yaqwsx/LaserProjector/README.md

# LaserProjector
Fancy driver for cheap Chinese laser galvos based on ESP32
