yaqwsx/LaserProjector/hw/mainBoard.kicad_pcb

## KiCad design hw/mainBoard.kicad_pcb (2017-08-06)

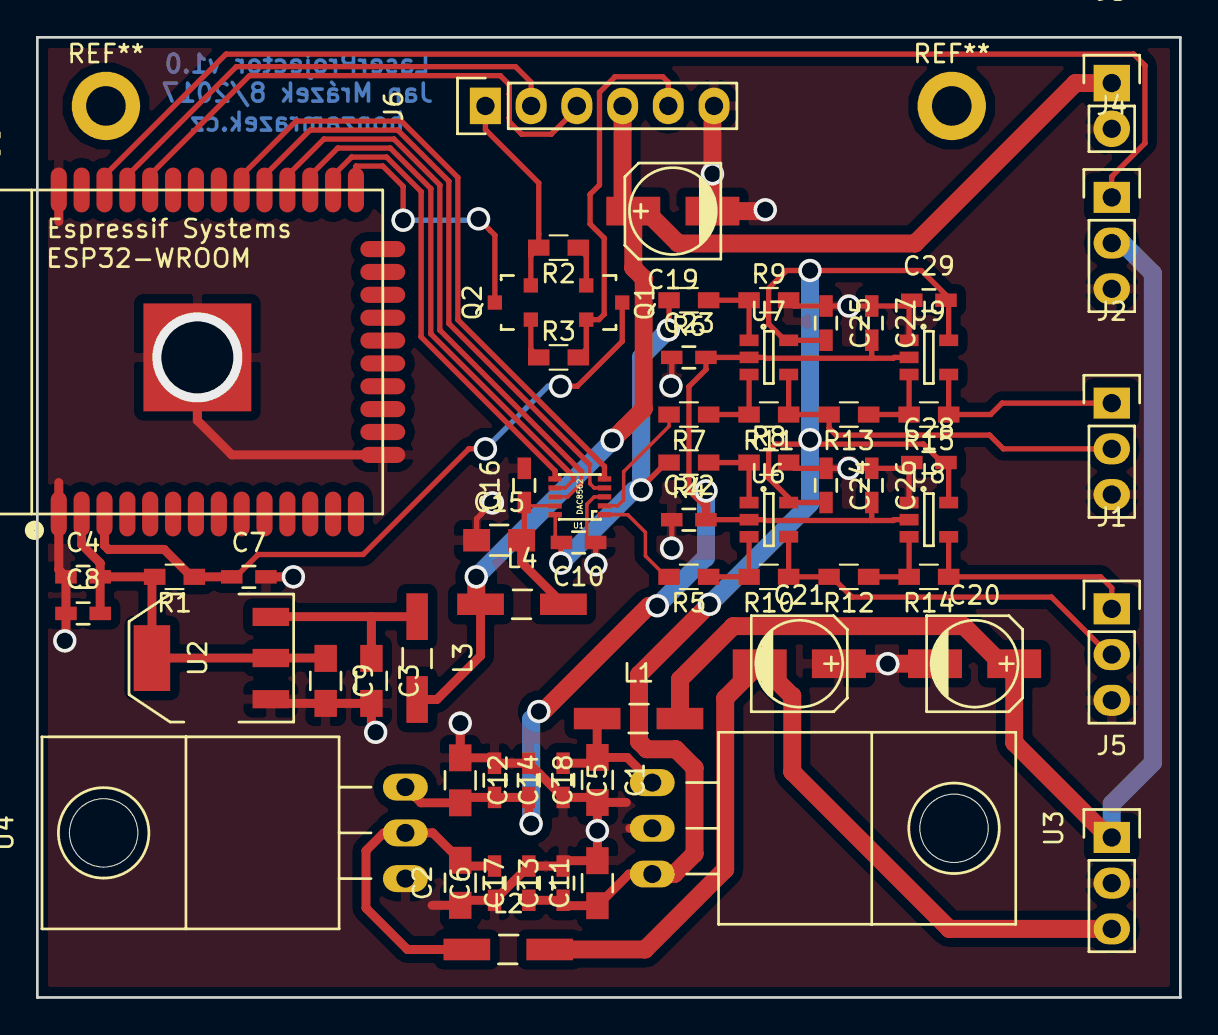
[picture p1: board mainBoard.kicad_pcb from above]

Board: 2 copper layers, 63.5 x 53.3 mm, 65 parts (0 on the bottom side), 38 nets.

Parts:
C1, C2, C3, C9, C11, C12, C15: 10u; C_0805_HandSoldering
C4: 470n; C_0603_HandSoldering
C5, C6, C8, C13, C14, C16, C22, C23, C24, C25, C26, C27, C28, C29: 100n; C_0603_HandSoldering
C7, C17, C18: 1n; C_0603_HandSoldering
C10: 150nF; C_0603_HandSoldering
C19, C20, C21: 120u; c_elec_5x5.7
J1: Y; Pin_Header_Straight_1x03
J2: X; Pin_Header_Straight_1x03
J3: PWR_5; Pin_Header_Straight_1x02
J4: LASER; Pin_Header_Straight_1x03
J5: PWR_15; Pin_Header_Straight_1x03
J6: FTDI; Pin_Header_Straight_1x06
L1, L2, L3, L4: 33uH; Choke_SMD_1206_Handsoldering
Q1, Q2: BC817; SOT-23
R1, R2, R3, R4, R5, R6, R7: 10k; R_0603_HandSoldering
R8, R9, R10, R11, R12, R13, R14, R15: 20k; R_0603_HandSoldering
U1: DAC8562; VSSOP10
U2: AP1117; SOT-223
U3: LM7809CT; TO-220_Neutral123_Horizontal
U4: LM7909CT; TO-220_Neutral123_Horizontal
U5: ESP32-WROOM
U6, U7, U8, U9: MIC920; SOT-23-5

Connections:
+3V3: C4.2, C8.2, C9.1, R1.2, U2.2, U2.4, U5.2
+5V: C19.1, J3.1, J6.4, L3.2, L4.1
+9VA: C11.1, C13.1, C17.1, C24.2, C25.2, C28.2, C29.2, U3.3, U6.5, U7.5, U8.5, U9.5
+15V: C20.1, J4.2, J5.1, L1.2
-9VA: C12.2, C14.2, C18.2, C22.2, C23.2, C26.2, C27.2, U4.3, U6.2, U7.2, U8.2, U9.2
-15V: C21.2, J5.3, L2.2
BOOT: Q2.3, U5.25
CLR: U1.5, U5.30
DATA: U1.8, U5.28
DTR: J6.1, Q2.2, R2.2
EN: C7.1, Q1.3, R1.1, U5.3
GND: C1.2, C2.1, C3.2, C4.1, C5.2, C6.1, C7.2, C8.1, C9.2, C10.1, C11.2, C12.1, C13.2, C14.1, C15.1, C16.2, C17.2, C18.1, C19.2, C20.2, C21.1, C22.1, C23.1, C24.1, C25.1, C26.1, C27.1, C28.1, C29.1, J1.3, J2.3, J3.2, J4.3, J5.2, J6.6, R8.2, R9.2, U1.3, U2.1, U3.2, U4.1, U5.1, U5.15, U5.38, U5.39, U8.1, U9.1
LASER: J4.1, U5.36
LDAC: U1.4, U5.29
unnamed: C1.1, C5.1, L1.1, U3.1
unnamed: C2.2, C6.2, L2.1, U4.2
unnamed: C3.1, L3.1, U2.3
unnamed: C15.2, C16.1, L4.2, U1.9
unnamed: Q1.1, R2.1
unnamed: Q2.1, R3.1
unnamed: R4.1, R8.1, U6.1
unnamed: R6.1, R9.1, U7.1
unnamed: R5.1, R10.2, U6.3
unnamed: R7.1, R11.2, U7.3
unnamed: R12.1, R14.2, U8.3
unnamed: R13.1, R15.2, U9.3
RTS: J6.5, Q1.2, R3.2
RX: J6.2, U5.35
SCK: U1.7, U5.27
SIG_GROUND: C10.2, R4.2, R6.2, U1.10
SYNC: U1.6, U5.26
TX: J6.3, U5.34
XNEG: J2.1, R15.1, U9.4
XPOS: J2.2, R11.1, R13.2, U7.4
XSIG: R7.2, U1.2
YNEG: J1.1, R14.1, U8.4
YPOS: J1.2, R10.1, R12.2, U6.4
YSIG: R5.2, U1.1
