yaqwsx/LaserProjector/(commit log)

2017-08-01 Move transformations from interrupt to a task
2017-08-01 Initial schematic for the board
    [mainBoard.kicad_pcb, mainBoard.sch]
2017-08-02 Initial routing
    [mainBoard.kicad_pcb, mainBoard.sch]
2017-08-06 Add driver for new board
2017-08-06 Final touch on the board
    [mainBoard.kicad_pcb]
